iotatron/prolight-plm2000-manual-control/cad/hand_pendant.FCStd

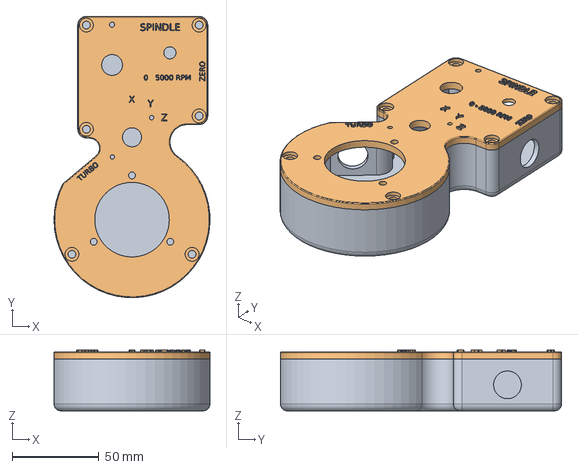
[picture p1: CAD file, 2026-10-11]
cad/hand_pendant.FCStd
90.0 x 162.2 x 35.0 mm
pendant_body
pendant_lid
