iotatron/prolight-plm2000-manual-control/cad/dro_unit.FCStd

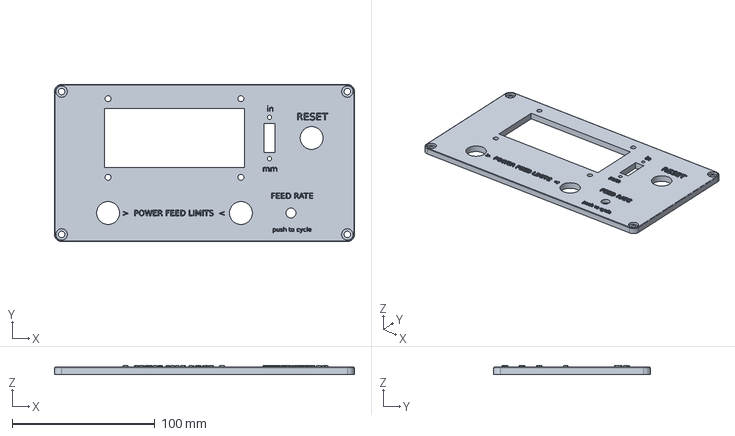
[picture p2: CAD file, 2026-10-11]
cad/dro_unit.FCStd
210.0 x 110.0 x 6.00 mm
