iotatron/prolight-plm2000-manual-control/(commit log)

2026-10-11 Added CAD files
    [dro_unit.FCStd, hand_pendant.FCStd]
2026-10-15 Added LICENSE; fixed travel limits in machine definition.
    [cnc_pendant.py]
